baltic-racing/03---HV_DCDC/README.md

# HV_DCDC_PCB
 600VDC-250VDC to 24V 700W
