baltic-racing/03---HV_DCDC/R41-AC-2202.pdf

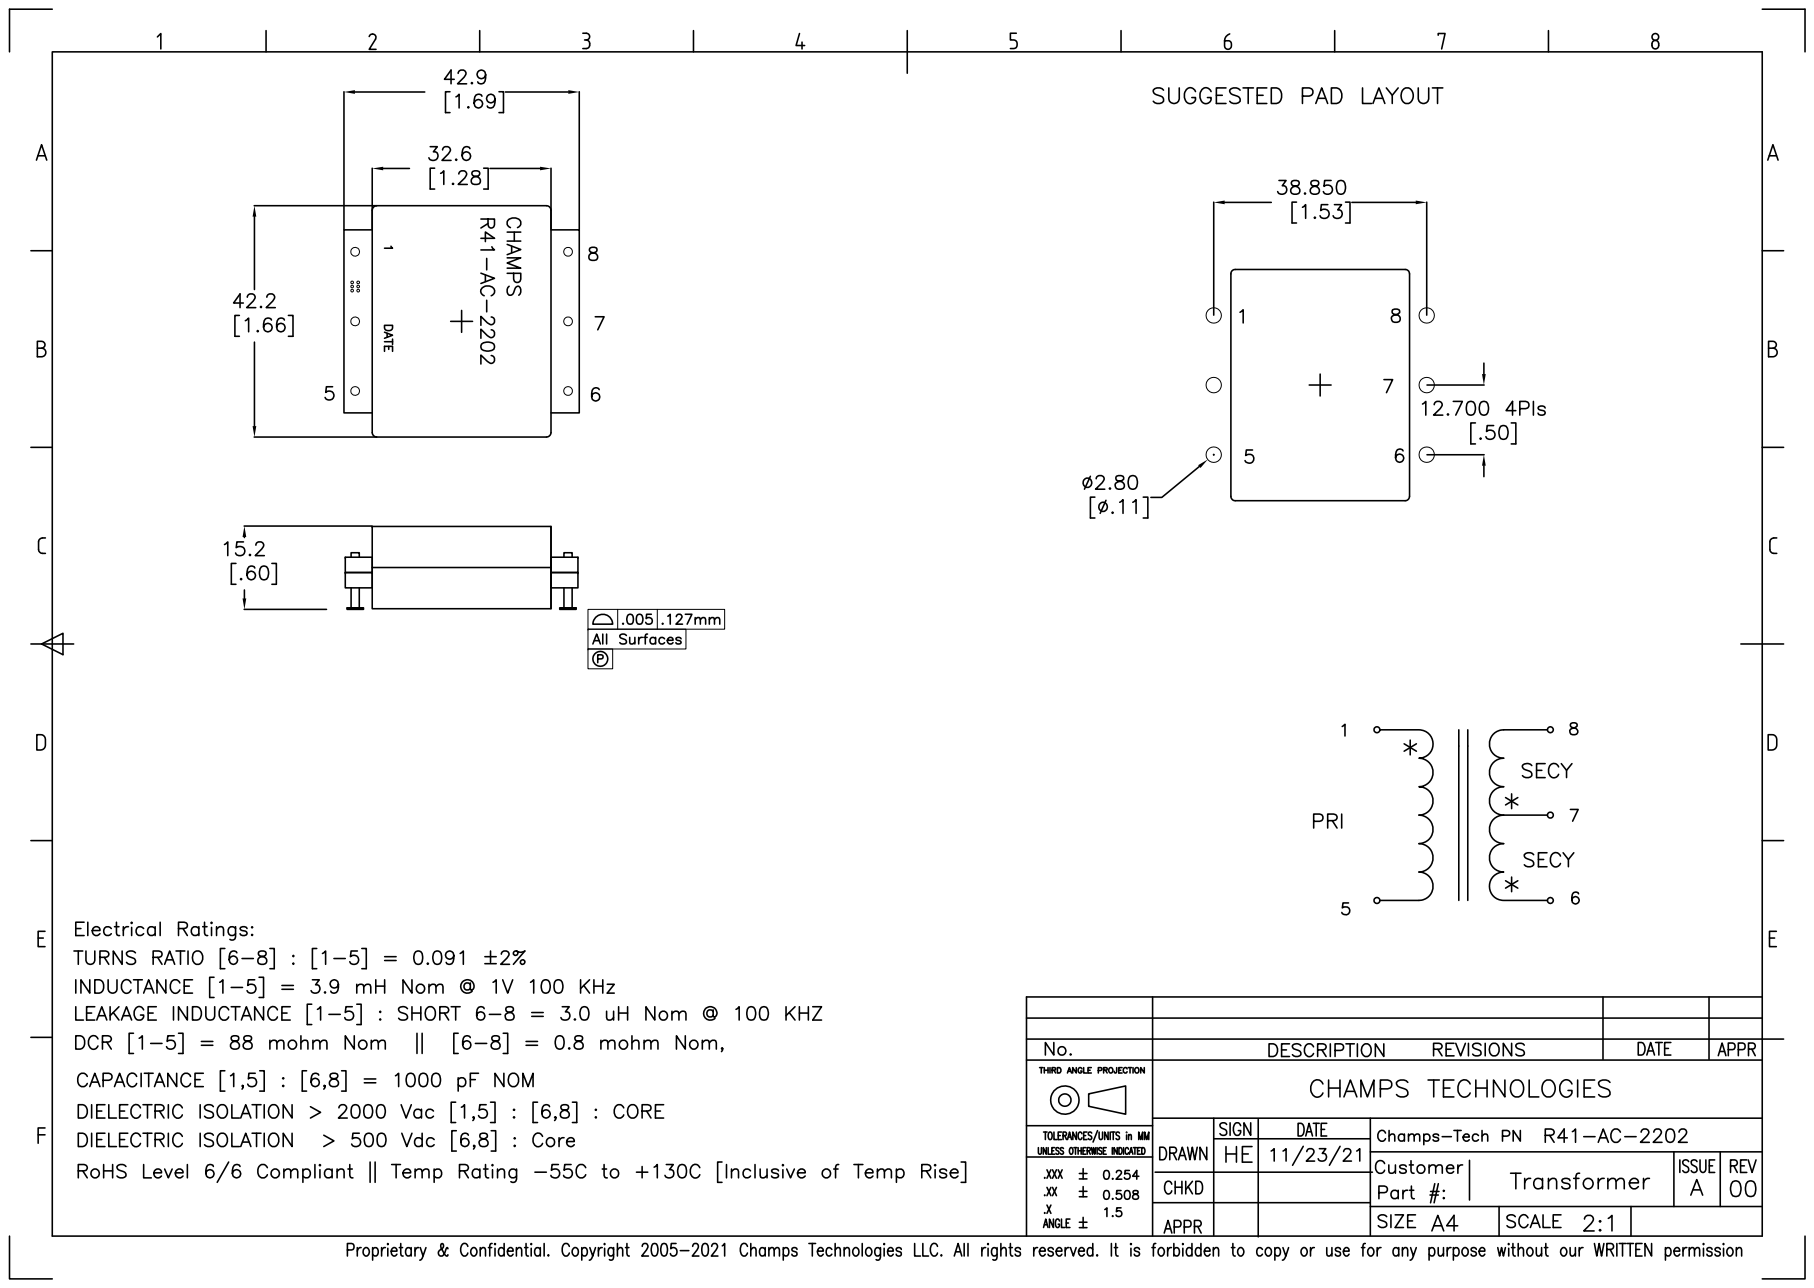
[picture p1: page 1]
