baltic-racing/03---HV_DCDC/LT3752-1_LT8311_HVDCDC_V9.asc

C1: cap; .033µ
C2: cap; 22µ; x2; V=25 Irms=0 Rser=0.00268514 Lser=906.891p mfg="Würth Elektronik" pn="885012109014 WCAP-CSGP 1210" type="X5R"
C3: cap; 4.7µ
C4: cap; 4.7µ
C5: cap; 68p
C6: cap; 220p
C7: cap; .022µ
C8: cap; .047µ
C9: cap; .047µ
C10: cap; 150p
C11: cap; 4.7n
C12: cap; 2.2µ; ic=9.49
C13: cap; 3.3n
C14: cap; 22µ
C15: cap; 22µ
C16: cap; 1µ
C17: cap; 470p; Rpar=10K
C18: cap; 3.3n
C19: cap; 220n
C20: cap; 500p
C21: cap; 500p
C22: cap; 500p
C23: cap; 500p
C24: cap; 150p
C25: cap; 150p
C26: cap; 23.5n
C27: cap; 150p
C28: cap; 500p
C29: cap; 22µ; x2; V=25 Irms=0 Rser=0.00268514 Lser=906.891p mfg="Würth Elektronik" pn="885012109014 WCAP-CSGP 1210" type="X5R"
C30: polcap; 2200µ; V=35 Irms=1.29 Rser=0.026 Lser=10.7n mfg="Würth Elektronik" pn="860020580022 WCAP-ATG5 16x25" type="Al electrolytic"
C31: cap; 500p
D1: diode; MMSD4148
D2: schottky; BAT46WJ
D3: schottky; BAT46WJ
D4: diode; MMSD4148
D5: diode; MMSD4148
L1: ind2; 32.296µ; Rser=0.8m
L2: ind2; 3900µ; Rser=88m
L3: ind; 5.3µ
L4: ind2; 785µ; Rser=.6
L5: ind2; 785µ; Rser=.6
L6: ind2; 4m; Rser=24.3
L7: ind2; 46µ; Rser=.65
L8: ind2; 62.5µ; Rser=.45
L9: ind2; 2m; Rser=1.4
L10: ind2; 2m; Rser=1.4
L12: ind2; 32.296µ; Rser=0.8m
L13: ind2; 3900µ; Rser=88m
L15: ind; 5.3µ
M1: nmos; IRFL4310
M4: nmos; 2N7002
M5: nmos; STP8NM60
M7: nmos; IPP110N20N3
M8: nmos; IPB019N06L3
R1: res; 5m
R2: res; 10K
R3: res; 540
R4: res; 3470
R5: res; 1995
R6: res; 1Meg
R7: res; 3.16K
R8: res; 100
R9: res; 1K
R10: res; 530k
R11: res; 1000
R12: res; 200
R13: res; 78.7K
R14: res; 160k
R15: res; 10k
R16: res; 124K
R17: res; 40.2K
R18: res; 75K
R19: res; 1.5K
R20: res; 100
R21: res; .2
R22: res; 499
R23: res; 806
R24: res; 10K
R25: res; 100K
R26: res; 100K
R27: res; 1000
R28: res; 0.88m
R29: res; 748K
R30: res; 10
R31: res; 309
R32: res; 10
R33: res; 28K
R34: res; 12.7K
R35: res; 20K
R36: res; 5.62K
R37: res; 2.3k
R38: res; 100k
R39: res; 100k
R40: res; 100k
Rload: res; 2.4
U1: LT8311
U2: LT3752-1
U3: PC817B
V1: voltage; 600
Named nets: 0, IN, OUT, M1_Out, A_out, SWP, FG, CG, HOUT, CSW_H, CSW_L, FSW_L, FSW_H
.tran 0 50m 5m 2.5u uic
K2 L5 L4 1
K3 L6 L7 L8 1
K4 L9 L10 1
Note:
  Some values like those for SS capacitors have been changed to reduce simulation time. See datasheet for typical values.
  If the simulation model is not found please update with the "Sync Release" command from the "Tools" menu.
LT3752-1 - Active Clamp Synchronous Forward Controllers with Internal Housekeeping Controller.
LT8311 - Synchronous Rectifier Controller with Opto-Coupler Driver for Forward Converters.
960W Active Clamp Forward Converter with Synchronous Rectification
Input: 260V to 630V Nom. 450V    Output: 24V @ 40A
K5 L1 L2 1
K1 L12 L13 1
Ü=10.989
Lleak=Lprim*(1-k)
Lleak = 3uH @ 100Khz
R41-AC-2202
K=0.999231
R_prim = 88m
R_sec = 0.8m
Allowed?
Allowed?
