baltic-racing/03---HV_DCDC/Draft1.asc

C1: cap; 100n
D1: zener; KDZ20B
D3: zener; KDZ20B
M1: nmos; STP8NM60
M2: pmos; Si7137DP
R1: res; 100k
R2: res; 1000k
R3: res; 100
R4: res; 745
R9: res; 100
R10: res; 100k
R11: res; 1000k
R12: res; 745
U1: PC817A
U3: PC817A
V1: voltage; 240
V2: voltage; SINE(1 2 1)
V5: voltage; SINE(1 2 1)
V6: voltage; 240
Named nets: 0
.tran 5
