baltic-racing/03---HV_DCDC/(list of files, drawings)

Other design files:
HV_DCDC/HV_DCDC.PcbDoc
HV_DCDC/HV_DCDC.PrjPcb
HV_DCDC/HV_DCDC_V2.PcbDoc
HV_DCDC/In.SchDoc
HV_DCDC/Info.SchDoc
HV_DCDC/Out.SchDoc
HV_DCDC/Prim_CTRL.SchDoc
HV_DCDC/Sek_CTRL.SchDoc
HV_DCDC/Trafo.SchDoc
HV_DCDC/V_AUX.SchDoc
