baltic-racing/03---HV_DCDC/(commit log)

2021-11-12 initial commit of HV DCDC data
    [Main.SchDoc]
2021-11-21 inital commit of new Converter
    [DC_Converter_Calc.xlsx, HV_DCDC.PrjPcb, Main.SchDoc]
2021-11-21 started new DCDC project. Ultralibrarian suck af
    [HV_DCDC.PcbDoc, HV_DCDC.PrjPcb, Main.SchDoc]
2021-11-26 tested sim with different input voltages
    [DC_Converter_Calc.xlsx]
2021-11-27 Lots of stuff
    Im tired now. worked on C_out, Duty Cycles, RC Snupper, clamp capacitance, on Voltage lokouts
    [DC_Converter_Calc.xlsx]
2021-11-29 did stuff
    [DC_Converter_Calc.xlsx]
2021-11-30 Calculated power losses and selected mosfets
    [DC_Converter_Calc.xlsx]
2021-12-04 Added IC's and Mosfets on the Schematic with complementary circuit
    [DC_Converter_Calc.xlsx]
2021-12-05 Put most parts on schematic and wired the up
    Still most need values
    and a few complementary circuits
    [DC_Converter_Calc.xlsx, HV_DCDC.PcbDoc]
2021-12-05 updated todo list
    [HV_DCDC.PcbDoc]
2021-12-07 added values to all R and C components
    [HV_DCDC.PrjPcb]
2021-12-08 started layouting the components on the PCB and added the complementary circuit
    [HV_DCDC.PrjPcb]
2021-12-08 working on optimizing f_osc and redone sim modell with proper connection of transformer
    [DC_Converter_Calc.xlsx]
2021-12-09 new coils and higher f_osc plus new layouting
    [HV_DCDC.PrjPcb]
2021-12-10 added FAN connector
2021-12-13 modified HV Switch to Low side switch
2021-12-13 added HV spacing lines on overlay
    [HV_DCDC.PrjPcb]
2021-12-19 modified low side switch simulation
2022-01-07 Update DC_Converter_Calc.xlsx
    added radiator calc for mosfets
    [DC_Converter_Calc.xlsx]
2022-01-10 added and imprioved on cooler calcualtion for mosfets
    [DC_Converter_Calc.xlsx]
2022-01-10 worked on mosfet cooler calc
    [DC_Converter_Calc.xlsx]
2022-01-10 Worked on PCB and schematic
    removed intermediary mosfets in the output stage, they take to much spac with the coolers added. it wont fit like that and it should still work without them ontop it is more efficient. Added cooler to PCB, PCB needs to be enlarged to about 135mm and component placing needs to be reconsiderd.
    [HV_DCDC.PrjPcb]
2022-01-16 modified HV GND net Connector
2022-02-05 Added Voltage Paramerter to CAPS
2022-02-05 Broke up the main schematic into subschematics. Added Voltage paramter to CPAS where necessary
    [Active_Clamp.SchDoc, HV_DCDC.PrjPcb, IN_OUT_Switch.SchDoc, Primary_Transformer.SchDoc, V_AUX.SchDoc]
2022-02-05 Beautyfication of schematics
    [Active_Clamp.SchDoc, IN_OUT_Switch.SchDoc, Primary_Transformer.SchDoc, V_AUX.SchDoc]
2022-02-05 Moved mosfet to clear IVT
2022-02-05 Changed Current shunt R13 out for 3 smaller resistors in Parallel
    [Primary_Transformer.SchDoc]
2022-02-05 modified resistor packages
    [Active_Clamp.SchDoc, IN_OUT_Switch.SchDoc, V_AUX.SchDoc]
2022-02-10 added screw holes
2022-02-11 changed 2 parts becouse of avaliability
    [V_AUX.SchDoc]
2022-05-14 only visuals
    [DC_Converter_Calc.xlsx, IN_OUT_Switch.SchDoc]
2022-06-09 added thyristor crowbar (WIP) for overvoltage protection
    [Active_Clamp.SchDoc, HV_DCDC.PrjPcb, IN_OUT_Switch.SchDoc, Info.SchDoc, Primary_Transformer.SchDoc, Primary_Transformer_out.SchDoc]
2022-06-10 worked on triac crowbar, still wip
    [IN_OUT_Switch.SchDoc, Primary_Transformer_out.SchDoc]
2022-06-11 trow thyristor crowbar out the window and switch to tvs diode, cheaper and simpler
    [IN_OUT_Switch.SchDoc]
2022-06-11 added beginning for tvs diode
    [IN_OUT_Switch.SchDoc]
2022-06-11 rearanged schematics to make a more logical separation
    [Active_Clamp.SchDoc, HV_DCDC.PrjPcb, HV_DCDC_V2.PcbDoc, IN_OUT_Switch.SchDoc, In.SchDoc, Info.SchDoc, Out.SchDoc, Prim_CTRL.SchDoc]
2022-06-11 started new pcb worked on cutout under trafo but still problems
    [HV_DCDC.PrjPcb, HV_DCDC_V2.PcbDoc, In.SchDoc, Info.SchDoc, Out.SchDoc, Prim_CTRL.SchDoc, Sek_CTRL.SchDoc, Trafo.SchDoc]
2022-06-11 added dcdc pcb template
    [HV_DCDC_V2.PcbDoc]
2022-06-11 startet layout
    [In.SchDoc]
2022-06-12 continued layout
    [HV_DCDC.PrjPcb, Prim_CTRL.SchDoc, Sek_CTRL.SchDoc, V_AUX.SchDoc]
2022-06-12 finsihed sorta component placement
    [Info.SchDoc]
2022-06-12 finished layout
    [HV_DCDC.PrjPcb, In.SchDoc, Out.SchDoc, Prim_CTRL.SchDoc, Trafo.SchDoc, V_AUX.SchDoc]
2022-06-12 finishing touches
    [HV_DCDC.PrjPcb, Out.SchDoc]
2022-06-12 added gerber files
    [HV_DCDC.PrjPcb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]
2023-01-26 modified converter calc
    [DC_Converter_Calc.xlsx]
2023-02-05 added parts
    [HV_DCDC.PrjPcb]
